samaritan1998/esp32-desktop-robot/docs/images/marvin-183.png

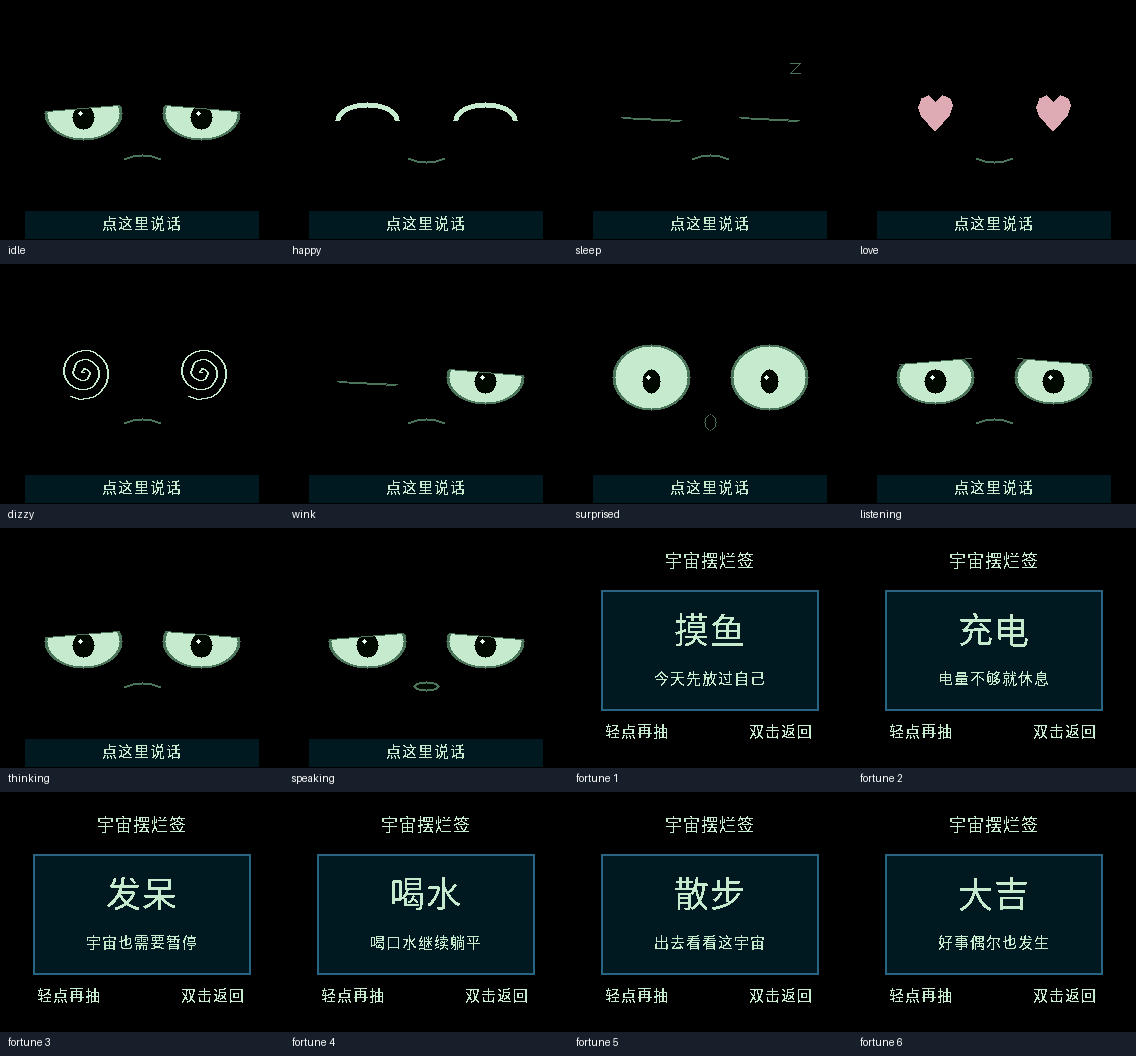
docs/images/marvin-183.png
