samaritan1998/esp32-desktop-robot/docs/images/walle-183.png

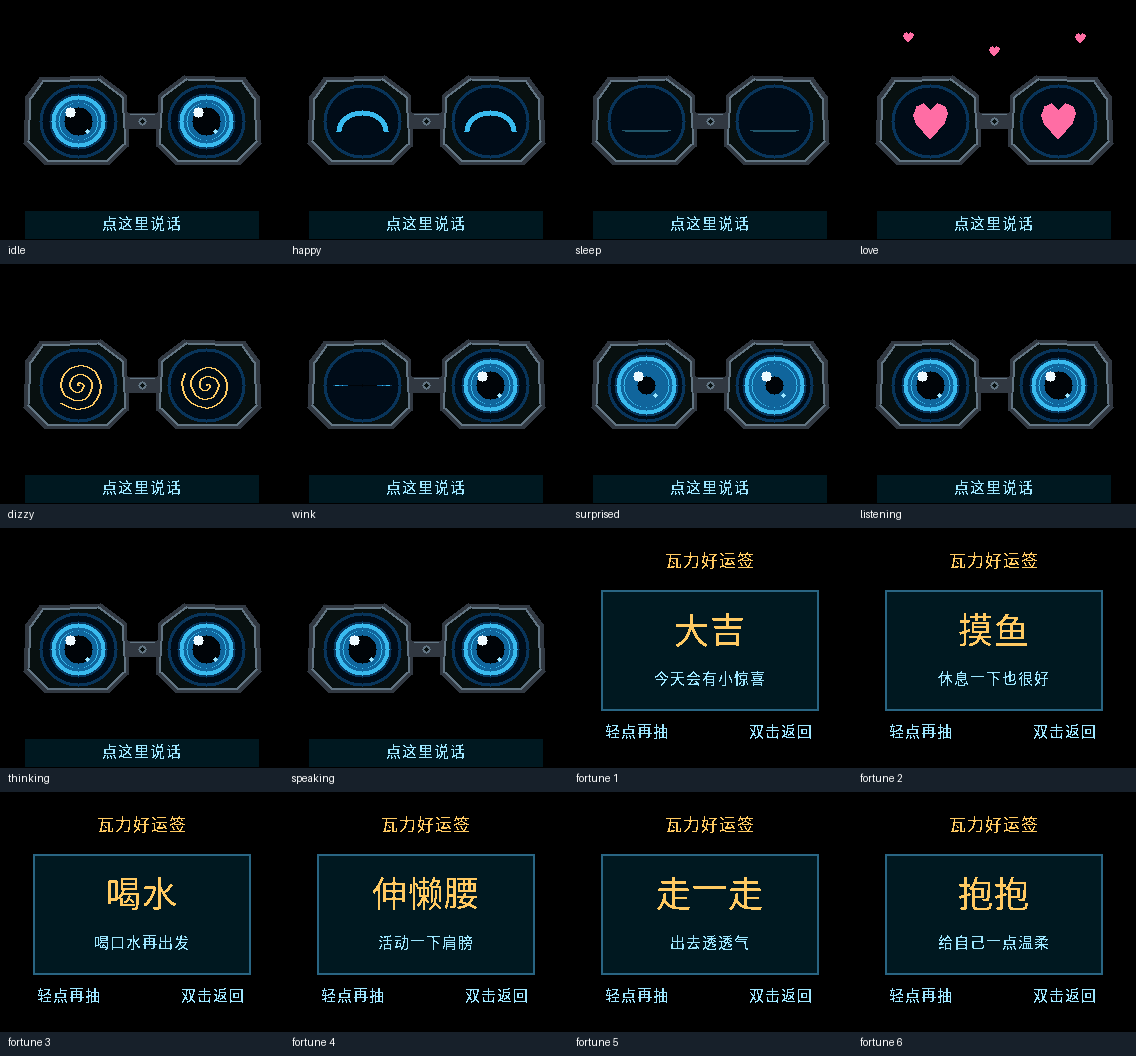
docs/images/walle-183.png
