samaritan1998/esp32-desktop-robot/models/marvin-v4/exploded.png

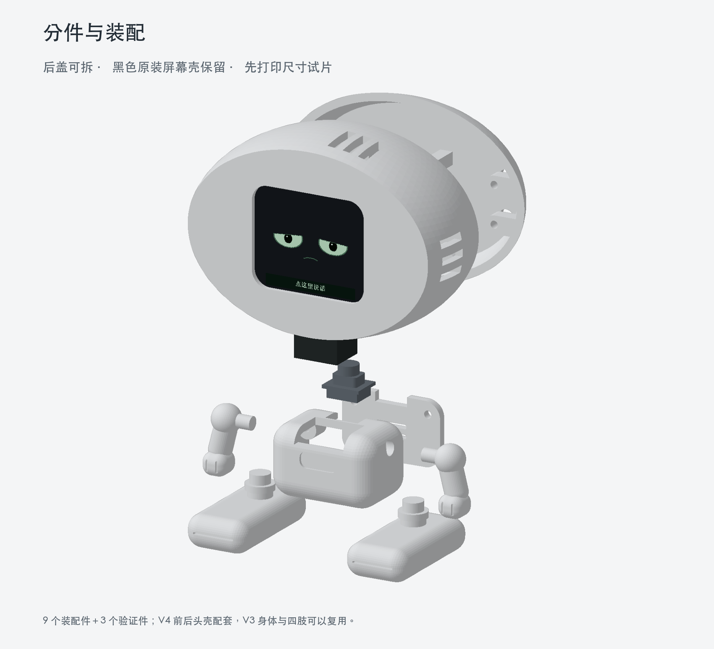
models/marvin-v4/exploded.png
