samaritan1998/esp32-desktop-robot/models/marvin-v4/打印排版.png

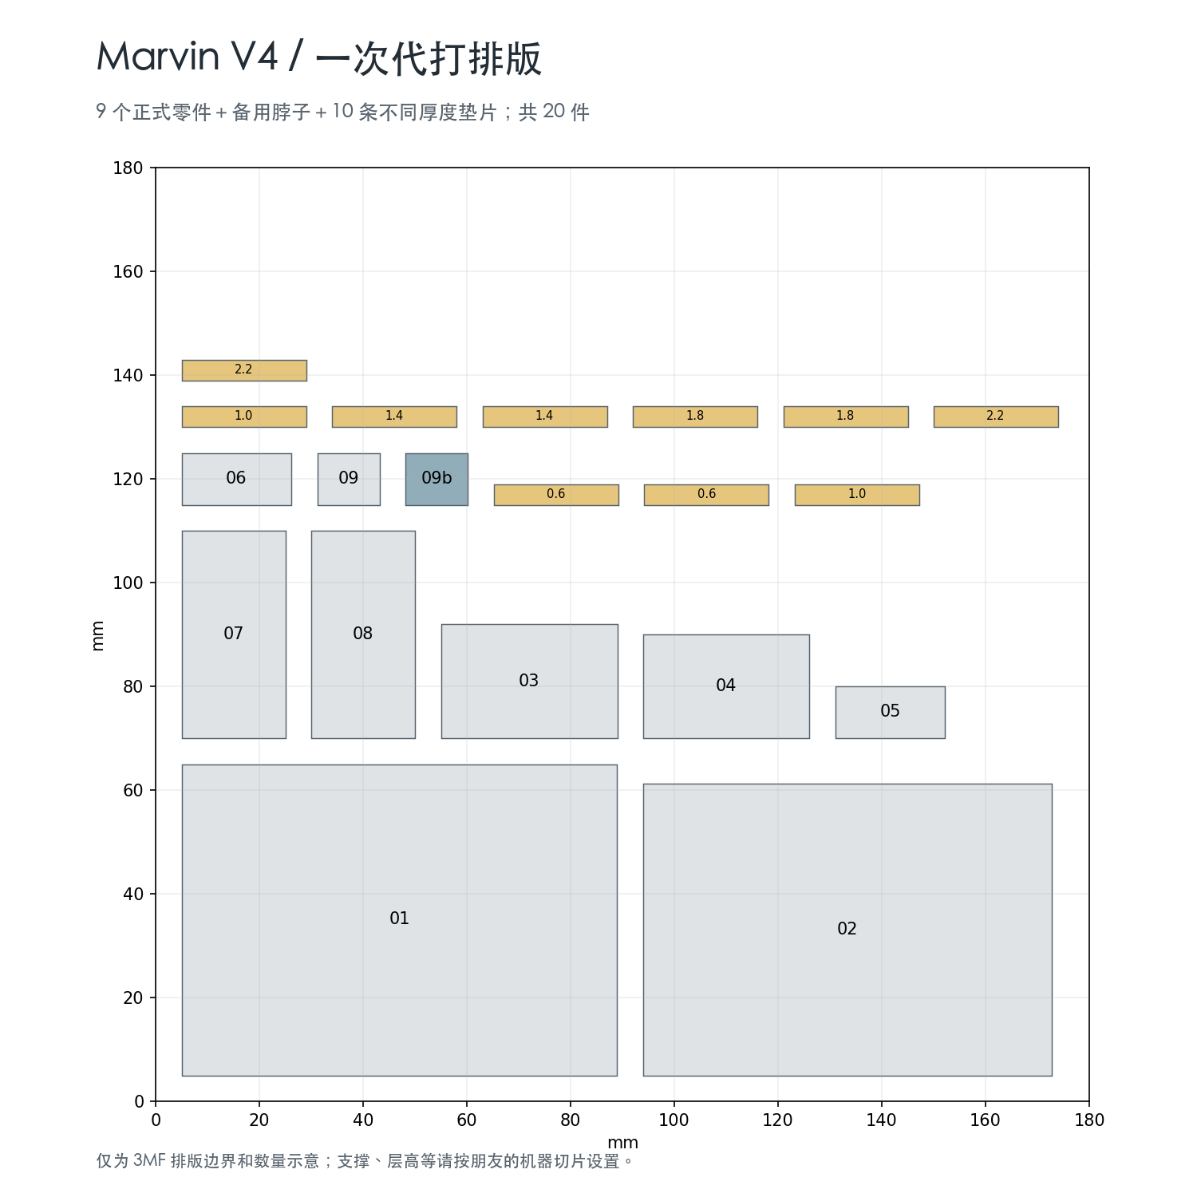
models/marvin-v4/打印排版.png
