samaritan1998/esp32-desktop-robot/models/walle/exploded.png

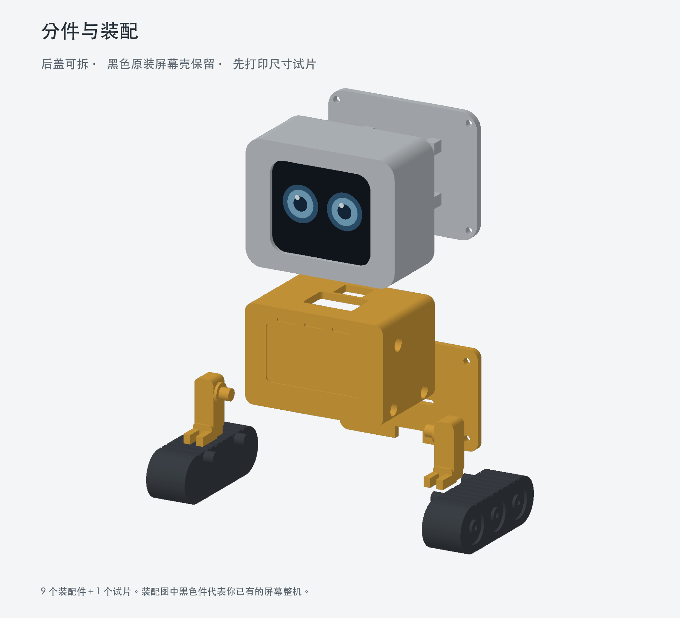
models/walle/exploded.png
