samaritan1998/esp32-desktop-robot/models/walle/assembly_preview.stl

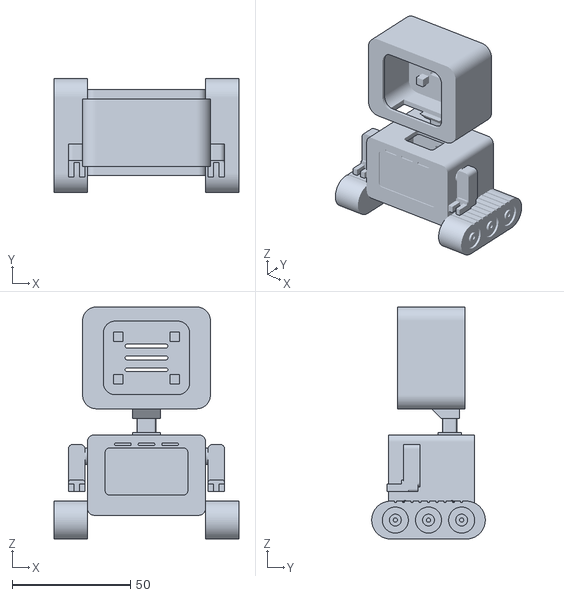
[picture p9: CAD file, 2026-10-23]
models/walle/assembly_preview.stl
78.0 x 48.0 x 98.0
