samaritan1998/esp32-desktop-robot/models/marvin-v4/一次打印排版_180mm.3mf

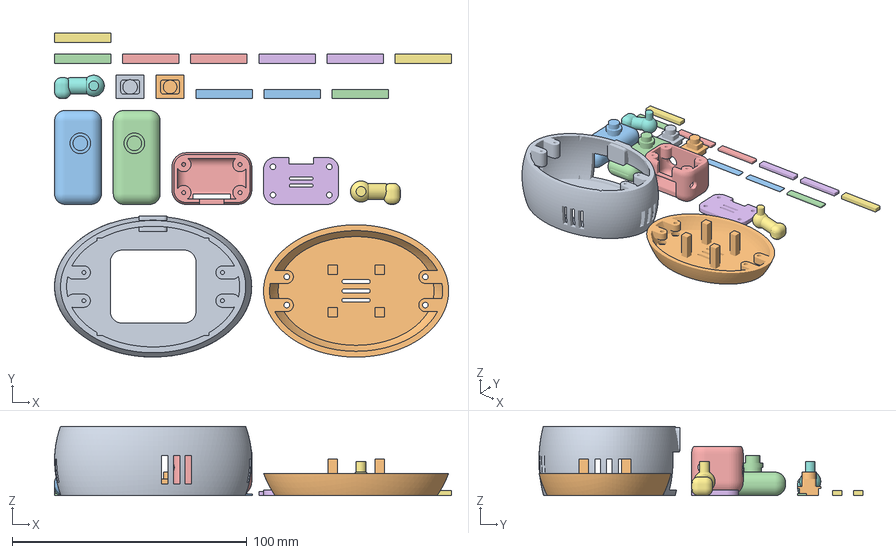
[picture p10: CAD file, 2026-10-23]
models/marvin-v4/一次打印排版_180mm.3mf
169.0 x 138.0 x 29.5 mm
01_head_front
02_head_back
07_foot_left
08_foot_right
03_body_shell
04_body_back
05_arm_left
06_arm_right
09_neck
09b_neck_loose_5p8
spacer_0p6mm x 2
spacer_1p0mm x 2
spacer_1p4mm x 2
spacer_1p8mm x 2
spacer_2p2mm x 2
