samaritan1998/esp32-desktop-robot/models/marvin-v4/正式零件/02_head_back.stl

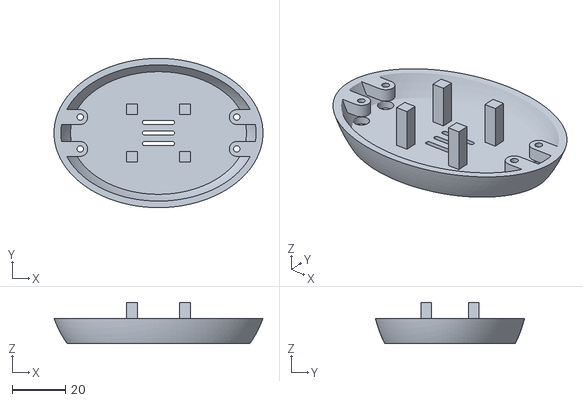
[picture p12: CAD file, 2026-10-23]
models/marvin-v4/正式零件/02_head_back.stl
78.8 x 56.3 x 15.6
