samaritan1998/esp32-desktop-robot/models/walle/stl/05_arm_left.stl

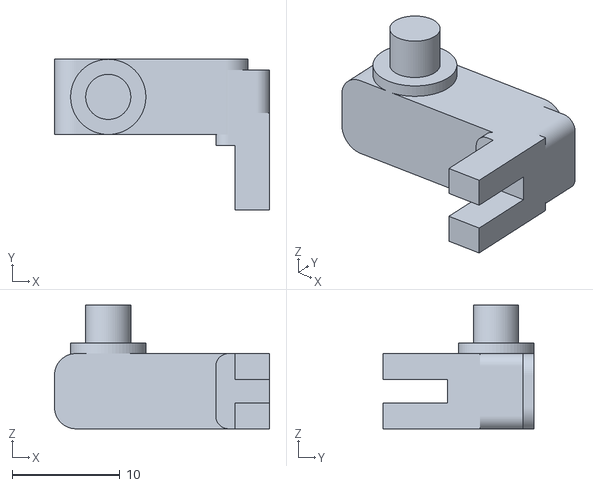
[picture p13: CAD file, 2026-10-23]
models/walle/stl/05_arm_left.stl
20.0 x 14.0 x 11.5
