samaritan1998/esp32-desktop-robot/models/marvin-v4/正式零件/05_arm_left.stl

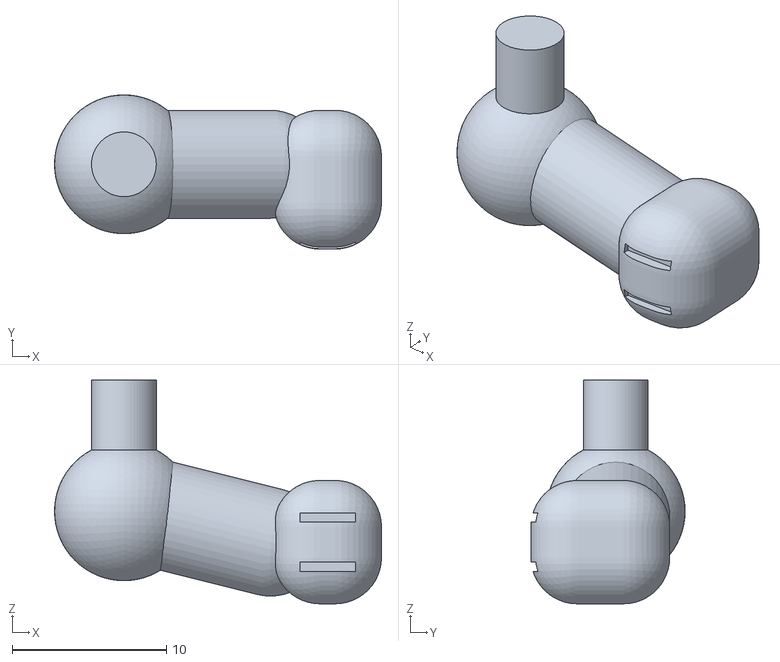
[picture p15: CAD file, 2026-10-23]
models/marvin-v4/正式零件/05_arm_left.stl
21.2 x 10.0 x 14.5
