samaritan1998/esp32-desktop-robot/models/walle/stl/08_head_shell.stl

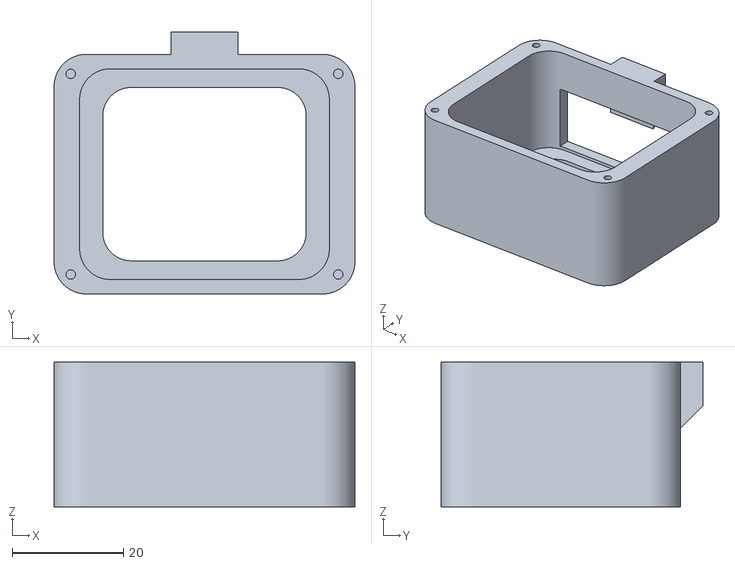
[picture p16: CAD file, 2026-10-23]
models/walle/stl/08_head_shell.stl
54.0 x 47.0 x 26.0
