samaritan1998/esp32-desktop-robot/models/marvin-v4/正式零件/04_body_back.stl

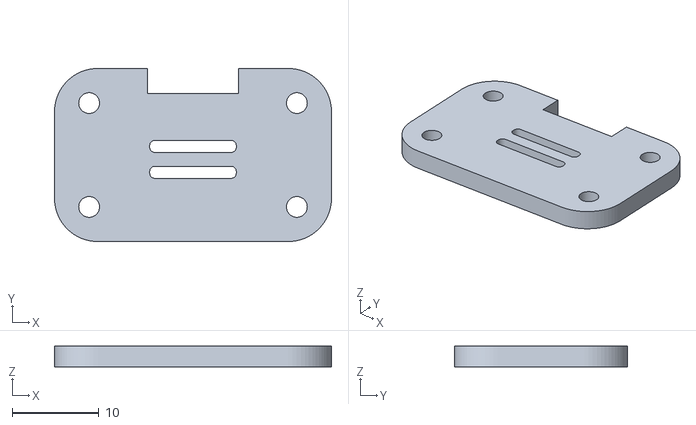
[picture p18: CAD file, 2026-10-23]
models/marvin-v4/正式零件/04_body_back.stl
32.0 x 20.0 x 2.40
