samaritan1998/esp32-desktop-robot/models/walle/stl/02_body_back.stl

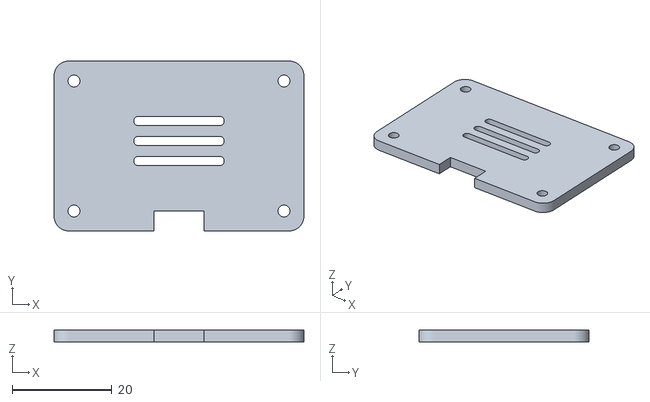
[picture p19: CAD file, 2026-10-23]
models/walle/stl/02_body_back.stl
50.0 x 34.0 x 2.40
