samaritan1998/esp32-desktop-robot/models/marvin-v4/备用垫片/spacer_0p6mm.stl

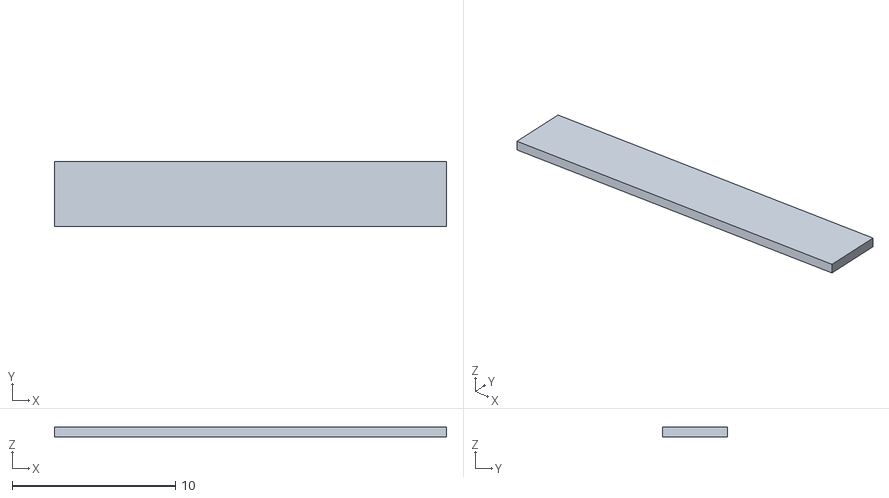
[picture p20: CAD file, 2026-10-23]
models/marvin-v4/备用垫片/spacer_0p6mm.stl
24.0 x 4.00 x 0.6
