samaritan1998/esp32-desktop-robot/models/marvin-v4/正式零件/03_body_shell.stl

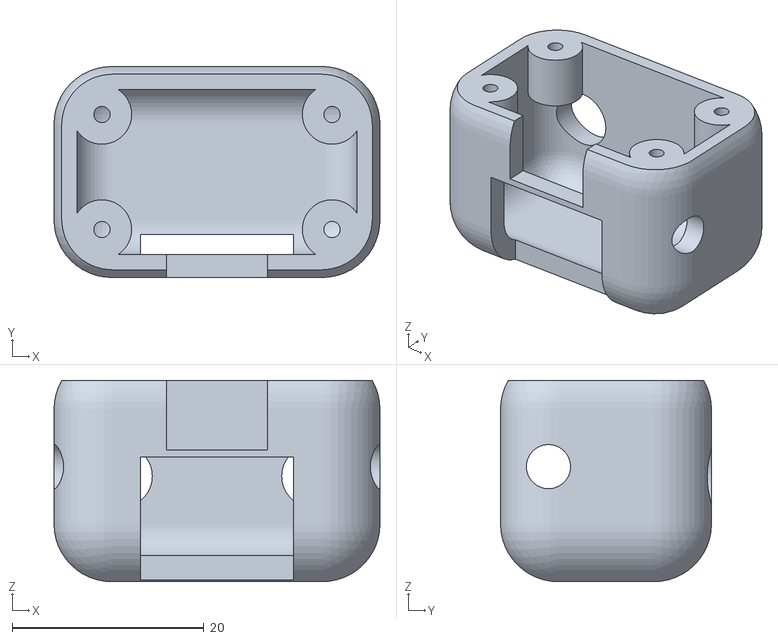
[picture p21: CAD file, 2026-10-23]
models/marvin-v4/正式零件/03_body_shell.stl
34.0 x 22.0 x 21.0
