samaritan1998/esp32-desktop-robot/models/walle/stl/04_track_right.stl

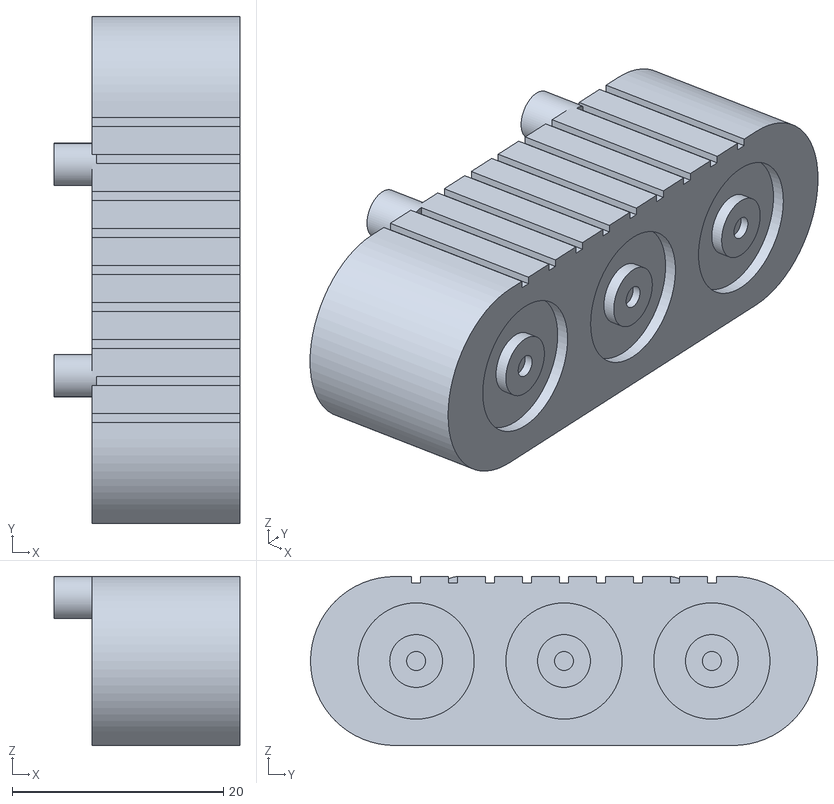
[picture p22: CAD file, 2026-10-23]
models/walle/stl/04_track_right.stl
17.6 x 48.0 x 16.0
