samaritan1998/esp32-desktop-robot/models/marvin-v4/备用垫片/spacer_1p8mm.stl

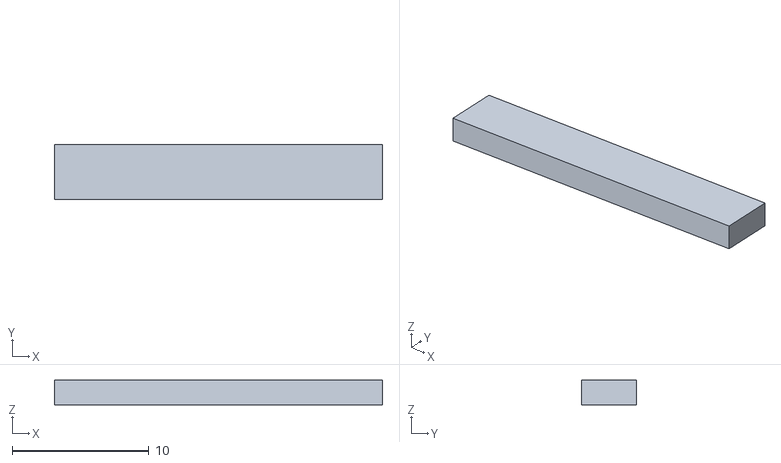
[picture p23: CAD file, 2026-10-23]
models/marvin-v4/备用垫片/spacer_1p8mm.stl
24.0 x 4.00 x 1.80
