samaritan1998/esp32-desktop-robot/models/marvin-v4/正式零件/01_head_front.stl

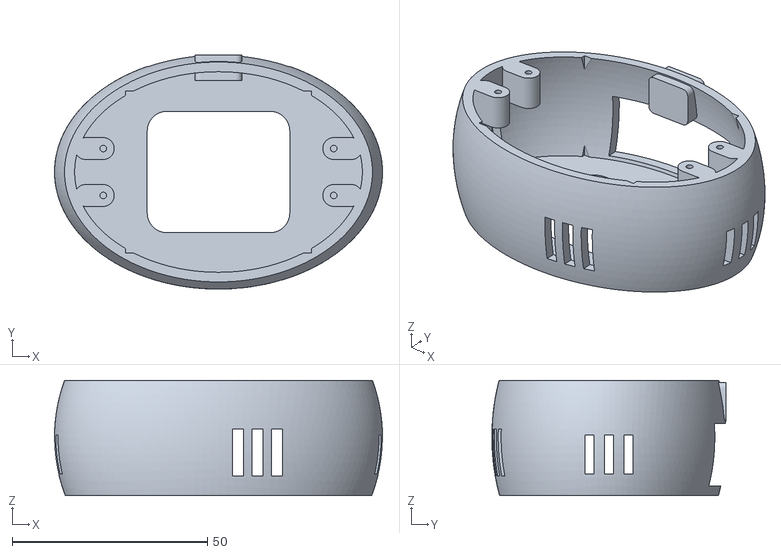
[picture p24: CAD file, 2026-10-23]
models/marvin-v4/正式零件/01_head_front.stl
84.0 x 60.0 x 29.5
