samaritan1998/esp32-desktop-robot/models/walle/stl/07_neck.stl

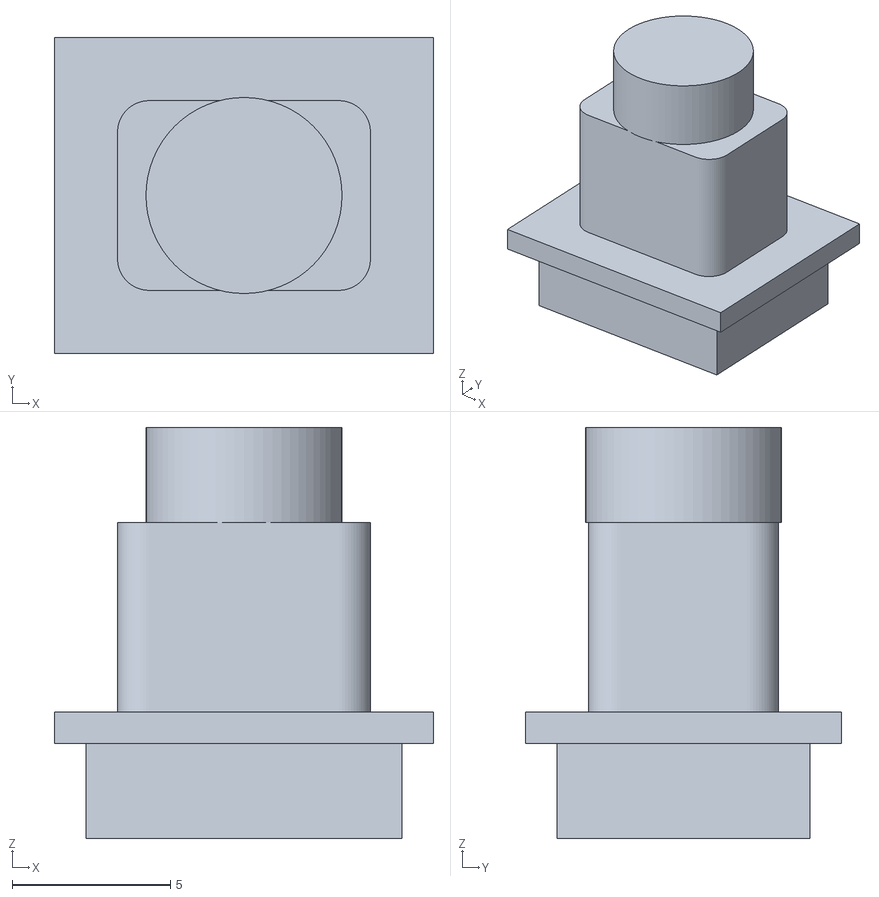
[picture p25: CAD file, 2026-10-23]
models/walle/stl/07_neck.stl
12.0 x 10.0 x 13.0
