samaritan1998/esp32-desktop-robot/models/marvin-v4/备用垫片/09b_neck_loose_5p8.stl

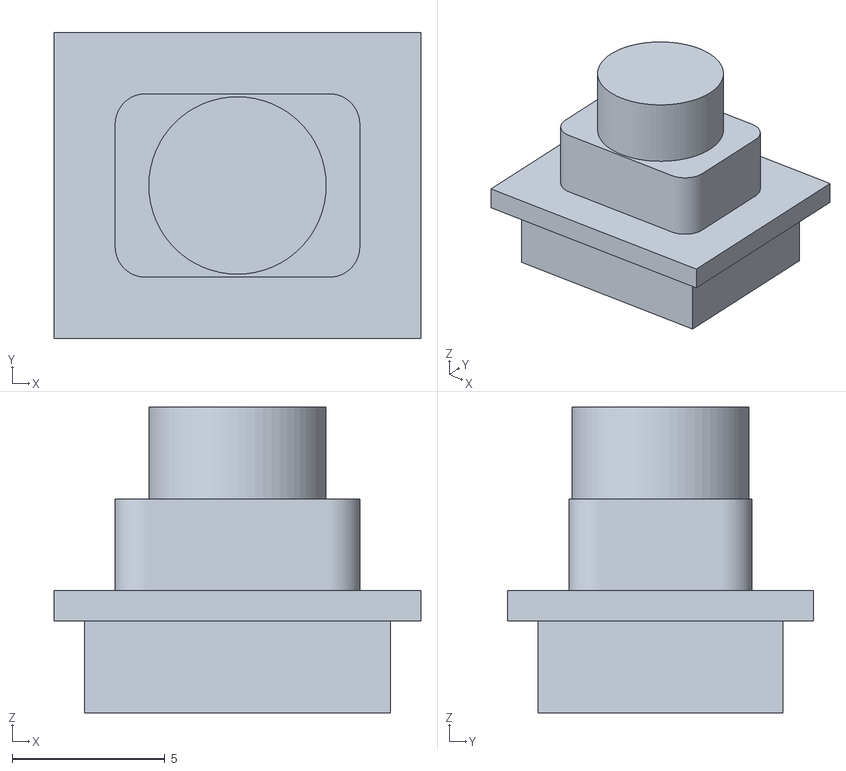
[picture p26: CAD file, 2026-10-23]
models/marvin-v4/备用垫片/09b_neck_loose_5p8.stl
12.0 x 10.0 x 10.0
