samaritan1998/esp32-desktop-robot/models/marvin-v4/正式零件/08_foot_right.stl

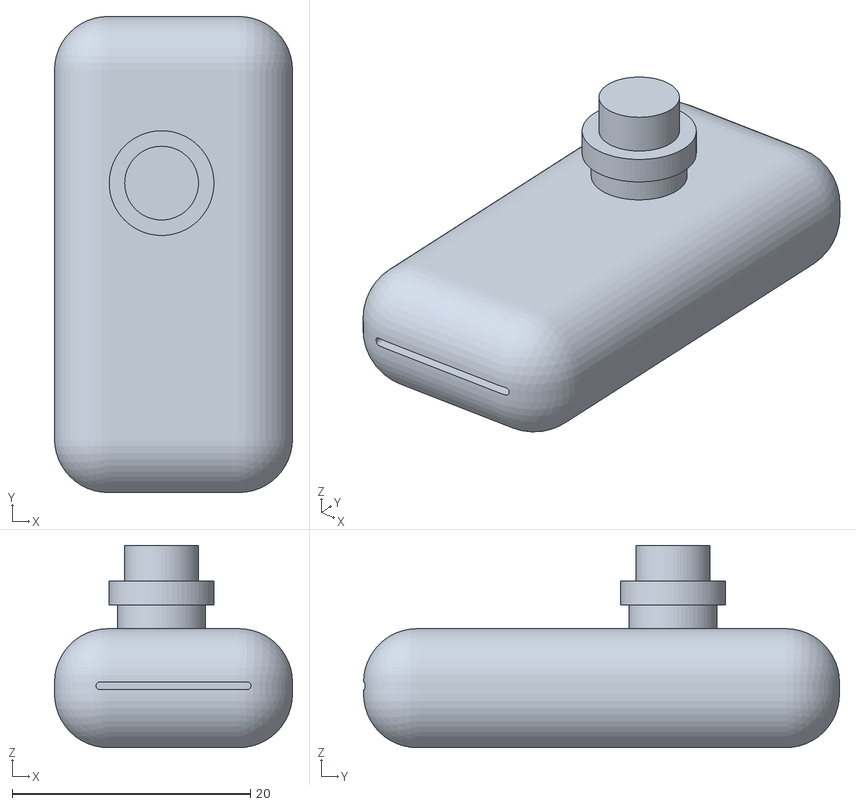
[picture p27: CAD file, 2026-10-23]
models/marvin-v4/正式零件/08_foot_right.stl
20.0 x 40.0 x 17.0
