samaritan1998/esp32-desktop-robot/models/walle/stl/10_fit_coupon.stl

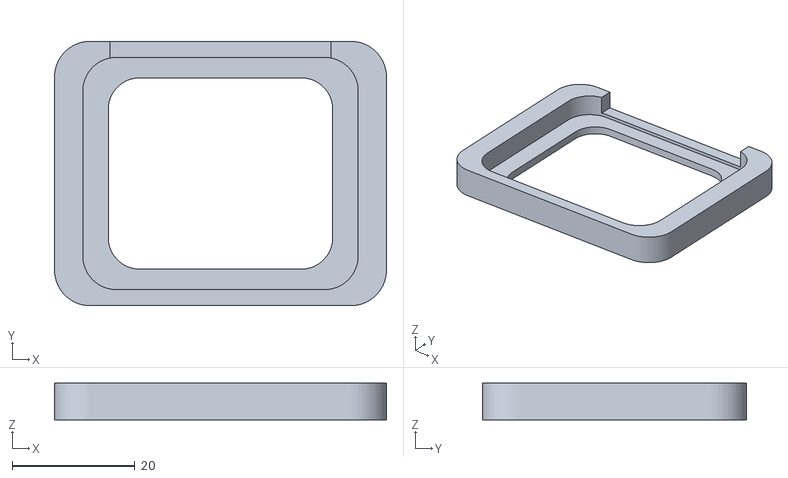
[picture p28: CAD file, 2026-10-23]
models/walle/stl/10_fit_coupon.stl
54.0 x 43.0 x 6.00
