samaritan1998/esp32-desktop-robot/models/walle/stl/09_head_back.stl

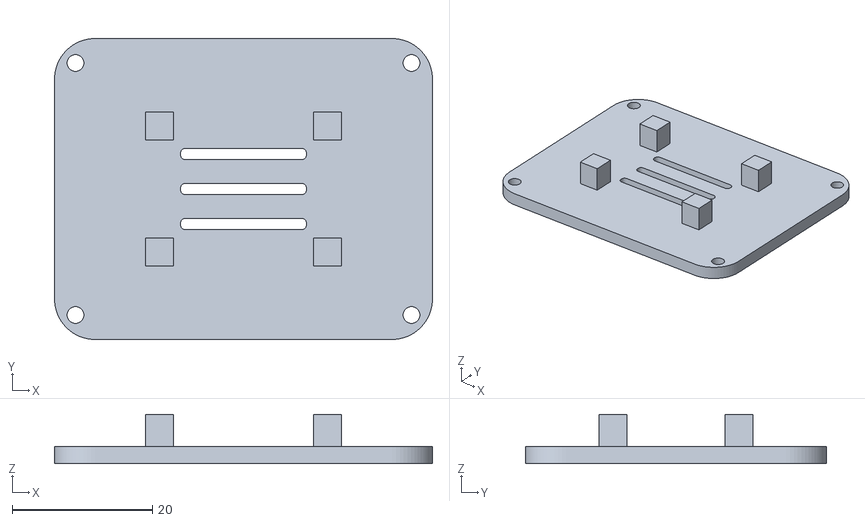
[picture p29: CAD file, 2026-10-23]
models/walle/stl/09_head_back.stl
54.0 x 43.0 x 7.00
