samaritan1998/esp32-desktop-robot/models/walle/stl/01_body_shell.stl

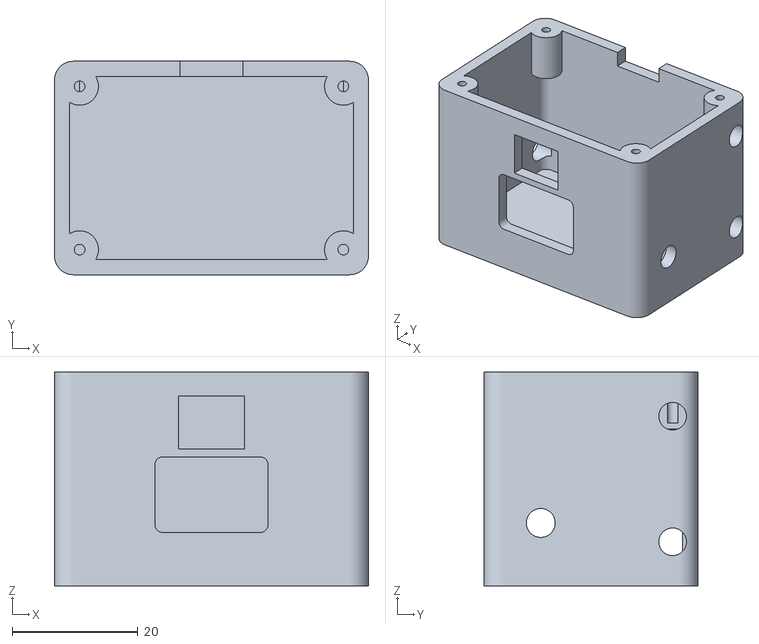
[picture p30: CAD file, 2026-10-23]
models/walle/stl/01_body_shell.stl
50.0 x 34.0 x 34.0
