samaritan1998/esp32-desktop-robot/(list of files, cad)

Other CAD files:
models/marvin-v4/正式零件/06_arm_right.stl
models/walle/stl/06_arm_right.stl
models/marvin-v4/正式零件/07_foot_left.stl
models/walle/stl/03_track_left.stl
models/marvin-v4/正式零件/09_neck.stl
