samaritan1998/esp32-desktop-robot/firmware/boards/marvin-183/marvin_board.cc

// SPDX-License-Identifier: MIT
#include "application.h"
#include "axp2101.h"
#include "button.h"
#include "codecs/box_audio_codec.h"
#include "config.h"
#include "i2c_device.h"
#include "led/single_led.h"
#include "marvin_display.h"
#include "mcp_server.h"
#include "power_save_timer.h"
#include "wifi_board.h"

#include <driver/i2c_master.h>
#include <driver/spi_master.h>
#include <esp_lcd_panel_vendor.h>
#include <esp_log.h>
#include "settings.h"

#include <esp_lcd_touch_cst816s.h>
#include <esp_lvgl_port.h>
#include <lvgl.h>

#define TAG "Marvin183"

class Pmic : public Axp2101 {
public:
    Pmic(i2c_master_bus_handle_t i2c_bus, uint8_t addr) : Axp2101(i2c_bus, addr) {
        // Enable the microphone supply only. Preserve charging settings.
        WriteReg(0x92, (3300 - 500) / 100);
        WriteReg(0x90, ReadReg(0x90) | 0x01);
    }
};

class Marvin183 : public WifiBoard {
private:
    i2c_master_bus_handle_t i2c_bus_;
    Pmic* pmic_ = nullptr;
    Button boot_button_;
    Display* display_;
    PowerSaveTimer* power_save_timer_;

    void InitializePowerSaveTimer() {
        power_save_timer_ = new PowerSaveTimer(-1, 60, 300);
        power_save_timer_->OnEnterSleepMode([this]() {
            GetDisplay()->SetPowerSaveMode(true);
            GetBacklight()->SetBrightness(20);
        });
        power_save_timer_->OnExitSleepMode([this]() {
            GetDisplay()->SetPowerSaveMode(false);
            Settings audio_settings("audio", true);
            if (audio_settings.GetInt("output_volume", -1) < 0) {
                audio_settings.SetInt("output_volume", 35);
            }
            GetBacklight()->RestoreBrightness();
        });
        power_save_timer_->OnShutdownRequest([this]() { pmic_->PowerOff(); });
        power_save_timer_->SetEnabled(true);
    }

    void InitializeCodecI2c() {
        // Initialize I2C peripheral
        i2c_master_bus_config_t i2c_bus_cfg = {
            .i2c_port = I2C_NUM_0,
            .sda_io_num = AUDIO_CODEC_I2C_SDA_PIN,
            .scl_io_num = AUDIO_CODEC_I2C_SCL_PIN,
            .clk_source = I2C_CLK_SRC_DEFAULT,
            .flags =
                {
                    .enable_internal_pullup = 1,
                },
        };
        ESP_ERROR_CHECK(i2c_new_master_bus(&i2c_bus_cfg, &i2c_bus_));
    }

    void InitializeAxp2101() {
        ESP_LOGI(TAG, "Init AXP2101");
        pmic_ = new Pmic(i2c_bus_, 0x34);
    }

    void InitializeSpi() {
        spi_bus_config_t buscfg = {};
        buscfg.mosi_io_num = DISPLAY_MOSI_PIN;
        buscfg.miso_io_num = GPIO_NUM_NC;
        buscfg.sclk_io_num = DISPLAY_CLK_PIN;
        buscfg.quadwp_io_num = GPIO_NUM_NC;
        buscfg.quadhd_io_num = GPIO_NUM_NC;
        buscfg.max_transfer_sz = DISPLAY_WIDTH * DISPLAY_HEIGHT * sizeof(uint16_t);
        ESP_ERROR_CHECK(spi_bus_initialize(SPI3_HOST, &buscfg, SPI_DMA_CH_AUTO));
    }

    void InitializeButtons() {
        boot_button_.OnClick([this]() {
            auto& app = Application::GetInstance();
            if (app.GetDeviceState() == kDeviceStateStarting) {
                EnterWifiConfigMode();
                return;
            }
            app.ToggleChatState();
        });

#if CONFIG_USE_DEVICE_AEC
        boot_button_.OnDoubleClick([this]() {
            auto& app = Application::GetInstance();
            if (app.GetDeviceState() == kDeviceStateIdle) {
                app.SetAecMode(app.GetAecMode() == kAecOff ? kAecOnDeviceSide : kAecOff);
            }
        });
#endif
    }

    void InitializeDisplay() {
        esp_lcd_panel_io_handle_t panel_io = nullptr;
        esp_lcd_panel_handle_t panel = nullptr;

        // 液晶屏控制IO初始化
        ESP_LOGD(TAG, "Install panel IO");
        esp_lcd_panel_io_spi_config_t io_config = {};
        io_config.cs_gpio_num = DISPLAY_CS_PIN;
        io_config.dc_gpio_num = DISPLAY_DC_PIN;
        io_config.spi_mode = DISPLAY_SPI_MODE;
        io_config.pclk_hz = 40 * 1000 * 1000;
        io_config.trans_queue_depth = 10;
        io_config.lcd_cmd_bits = 8;
        io_config.lcd_param_bits = 8;
        ESP_ERROR_CHECK(esp_lcd_new_panel_io_spi(SPI3_HOST, &io_config, &panel_io));

        // 初始化液晶屏驱动芯片
        ESP_LOGD(TAG, "Install LCD driver");
        esp_lcd_panel_dev_config_t panel_config = {};
        panel_config.reset_gpio_num = DISPLAY_RST_PIN;
        panel_config.rgb_ele_order = LCD_RGB_ELEMENT_ORDER_RGB;
        panel_config.bits_per_pixel = 16;
        ESP_ERROR_CHECK(esp_lcd_new_panel_st7789(panel_io, &panel_config, &panel));
        esp_lcd_panel_reset(panel);
        esp_lcd_panel_init(panel);
        esp_lcd_panel_invert_color(panel, true);
        // esp_lcd_panel_mirror(panel, DISPLAY_MIRROR_X, DISPLAY_MIRROR_Y);
        esp_lcd_panel_disp_on_off(panel, true);
        display_ = new MarvinDisplay(panel_io, panel, i2c_bus_);
    }

    void InitializeTouch() {
        // Same controller and mapping as the physically verified MicroPython v2.
        gpio_set_direction(GPIO_NUM_39, GPIO_MODE_OUTPUT);
        gpio_set_level(GPIO_NUM_39, 0);
        vTaskDelay(pdMS_TO_TICKS(10));
        gpio_set_level(GPIO_NUM_39, 1);
        vTaskDelay(pdMS_TO_TICKS(200));
    }

    // 初始化工具
    void InitializeTools() {
        auto& mcp_server = McpServer::GetInstance();
        mcp_server.AddTool("self.system.reconfigure_wifi",
                           "End this conversation and enter WiFi configuration mode.\n"
                           "**CAUTION** You must ask the user to confirm this action.",
                           PropertyList(), [this](const PropertyList& properties) {
                               EnterWifiConfigMode();
                               return true;
                           });
    }

public:
    Marvin183() : boot_button_(BOOT_BUTTON_GPIO) {
        InitializePowerSaveTimer();
        InitializeCodecI2c();
        InitializeAxp2101();
        InitializeSpi();
        InitializeTouch();
        InitializeDisplay();
        static_cast<MarvinDisplay*>(display_)->SetActivityCallback(
            [this]() { power_save_timer_->WakeUp(); });
        InitializeButtons();
        InitializeTools();
        Settings audio_settings("audio", true);
        if (audio_settings.GetInt("output_volume", -1) < 0) {
            audio_settings.SetInt("output_volume", 35);
        }
        GetBacklight()->RestoreBrightness();
    }

    virtual AudioCodec* GetAudioCodec() override {
        static BoxAudioCodec audio_codec(
            i2c_bus_, AUDIO_INPUT_SAMPLE_RATE, AUDIO_OUTPUT_SAMPLE_RATE, AUDIO_I2S_GPIO_MCLK,
            AUDIO_I2S_GPIO_BCLK, AUDIO_I2S_GPIO_WS, AUDIO_I2S_GPIO_DOUT, AUDIO_I2S_GPIO_DIN,
            AUDIO_CODEC_PA_PIN, AUDIO_CODEC_ES8311_ADDR, AUDIO_CODEC_ES7210_ADDR,
            AUDIO_INPUT_REFERENCE);
        return &audio_codec;
    }

    virtual Display* GetDisplay() override { return display_; }

    virtual Backlight* GetBacklight() override {
        static PwmBacklight backlight(DISPLAY_BACKLIGHT_PIN, DISPLAY_BACKLIGHT_OUTPUT_INVERT);
        return &backlight;
    }

    virtual bool GetBatteryLevel(int& level, bool& charging, bool& discharging) override {
        static bool last_discharging = false;
        charging = pmic_->IsCharging();
        discharging = pmic_->IsDischarging();
        if (discharging != last_discharging) {
            power_save_timer_->SetEnabled(discharging);
            last_discharging = discharging;
        }

        level = pmic_->GetBatteryLevel();
        return true;
    }

    virtual void SetPowerSaveLevel(PowerSaveLevel level) override {
        if (level != PowerSaveLevel::LOW_POWER) {
            power_save_timer_->WakeUp();
        }
        WifiBoard::SetPowerSaveLevel(level);
    }
};

DECLARE_BOARD(Marvin183);
