samaritan1998/esp32-desktop-robot/(commit log)

2026-10-23 Publish desktop robot models and firmware source
    [01_body_shell.stl, 01_head_front.stl, 02_body_back.stl, 02_head_back.stl, 03_body_shell.stl, 03_track_left.stl, 04_body_back.stl, 04_track_right.stl]
2026-10-26 Add illustrated assembly guides for both robot enclosures
